PARR-E/Pi-Python-Project/src/readme.md

This directory contains the course code created for this project. Since I was the only CS major on the project, I did the vast majority of the coding.
