PARR-E/Pi-Python-Project/design/MatthewK_Solidworks_Files/readme.md

The Solidowkrs model files used by Matthew Killy to create the 3D-printed components for the project.
