PARR-E/Pi-Python-Project/other/Arducam Pi Camera invoice (redacted).png

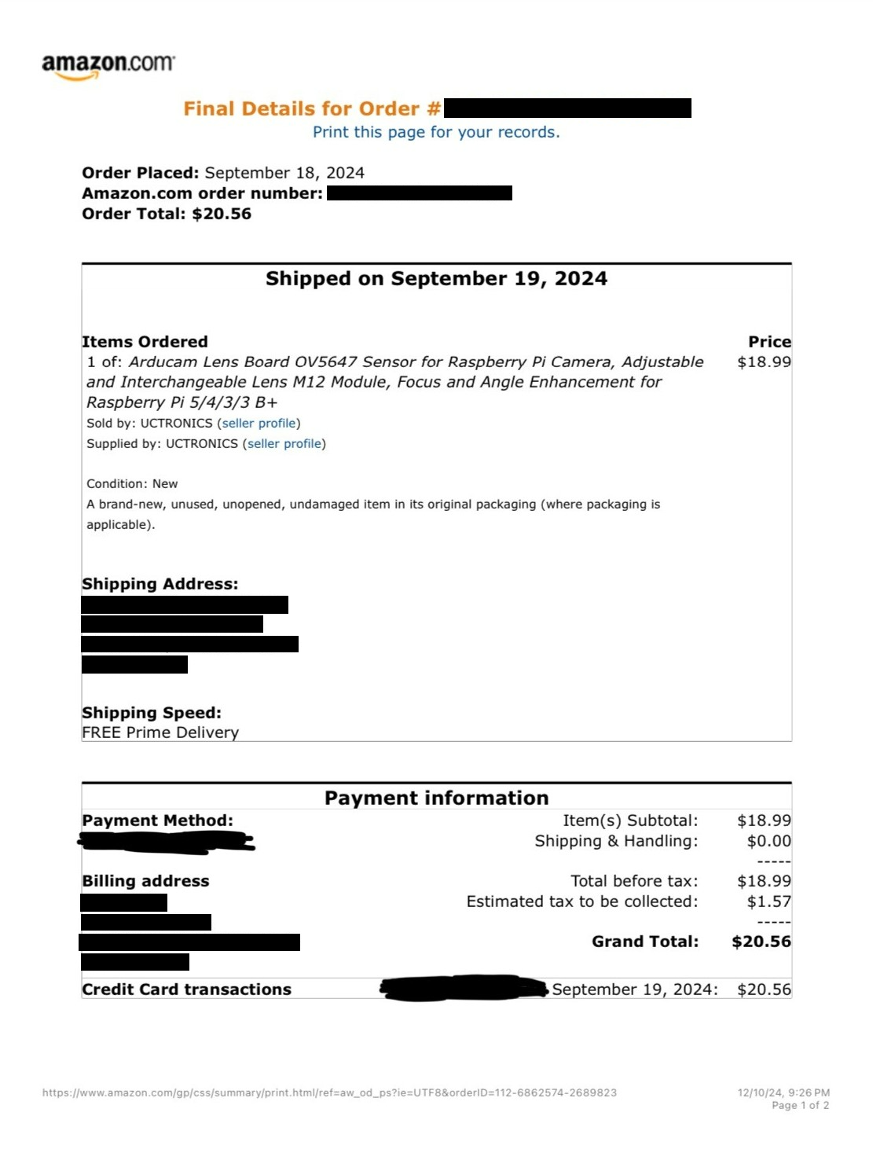
other/Arducam Pi Camera invoice (redacted).png
