PARR-E/Pi-Python-Project/other/CSI Flexible Cable invoice (redacted).png

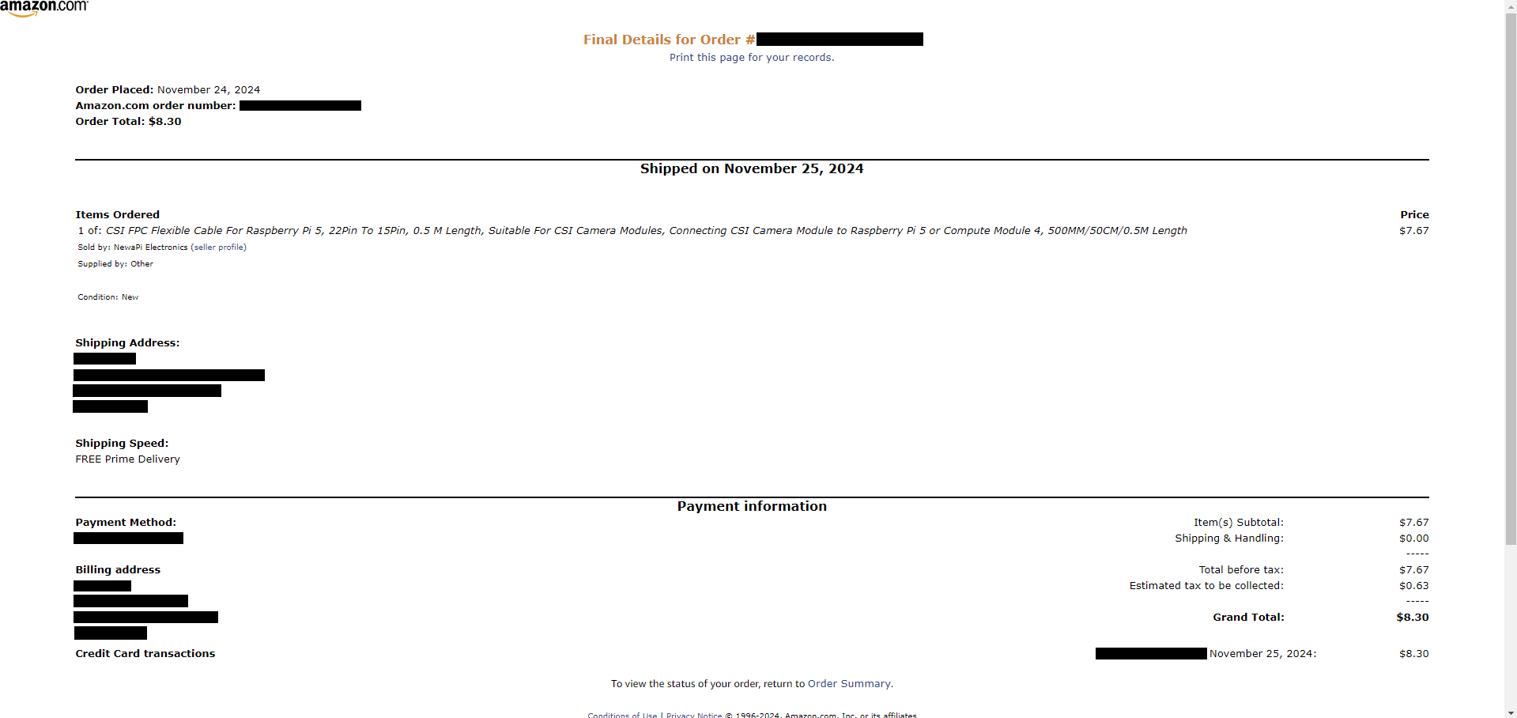
other/CSI Flexible Cable invoice (redacted).png
