PARR-E/Pi-Python-Project/design/MatthewK_Solidworks_Files/servo Assem.SLDASM

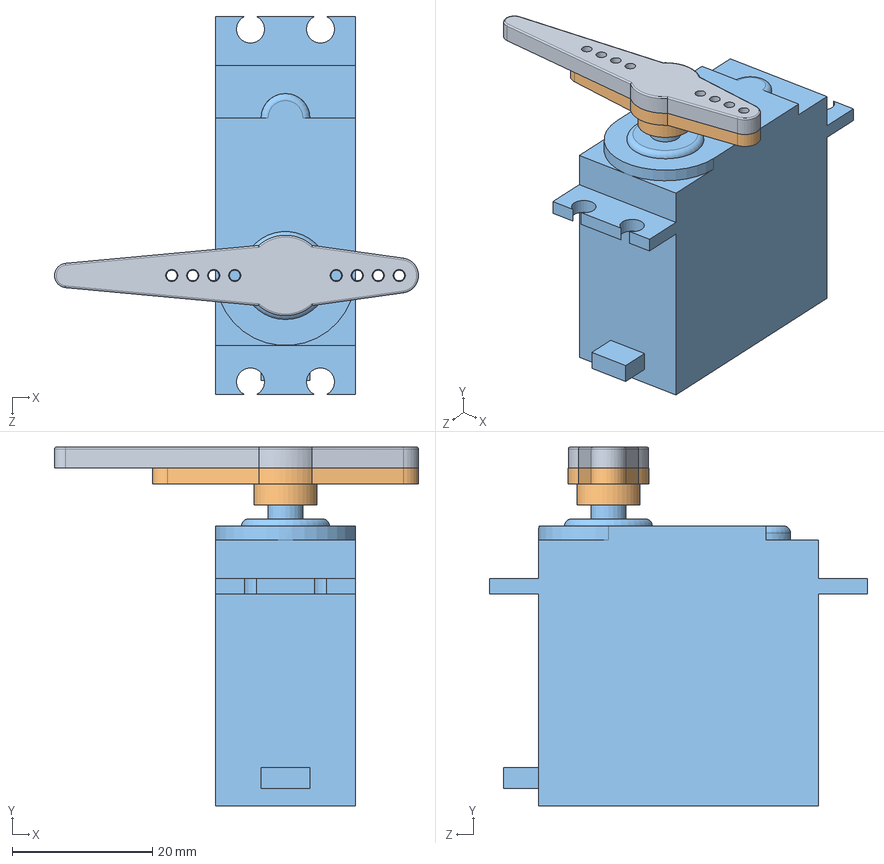
[picture p4: CAD file, 2025-05-14]
design/MatthewK_Solidworks_Files/servo Assem.SLDASM
52.0 x 51.2 x 54.0 mm
servo strong junk 2
Servo Horn
Servo Horn Extender
