PARR-E/Pi-Python-Project/design/MatthewK_Solidworks_Files/servo Assem 2.SLDASM

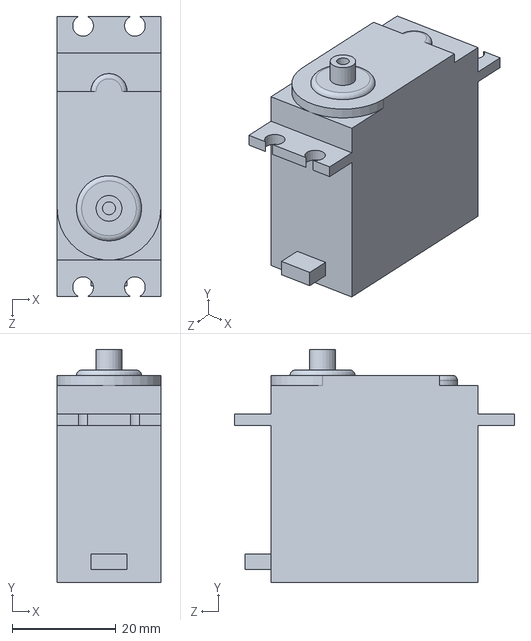
[picture p5: CAD file, 2025-05-14]
design/MatthewK_Solidworks_Files/servo Assem 2.SLDASM
20.0 x 45.0 x 54.0 mm
