PARR-E/Pi-Python-Project/design/MatthewK_Solidworks_Files/Main Bracket Part 1.SLDPRT

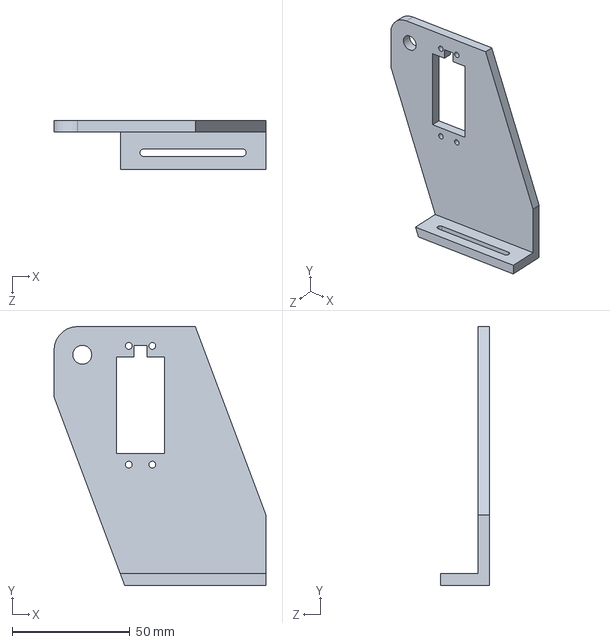
[picture p6: CAD file, 2025-05-14]
design/MatthewK_Solidworks_Files/Main Bracket Part 1.SLDPRT
90.0 x 110.0 x 21.0 mm
