PARR-E/Pi-Python-Project/design/MatthewK_Solidworks_Files/Main Bracket Part 2.SLDPRT

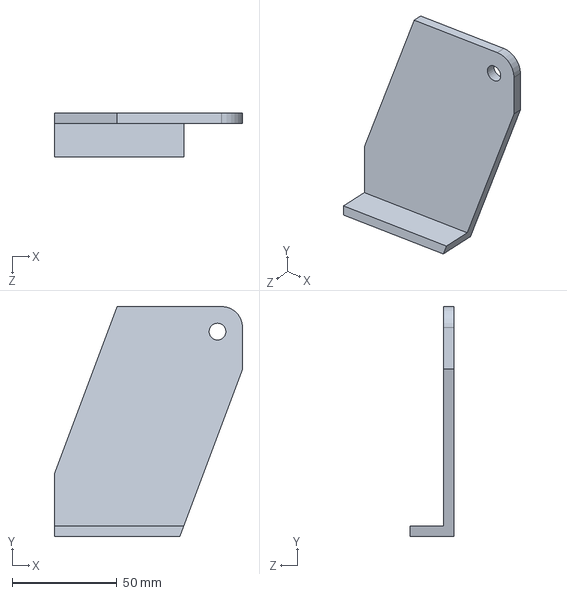
[picture p7: CAD file, 2025-05-14]
design/MatthewK_Solidworks_Files/Main Bracket Part 2.SLDPRT
90.0 x 110.0 x 21.0 mm
