PARR-E/Pi-Python-Project/design/MatthewK_Solidworks_Files/Servo Horn Extender 2.SLDPRT

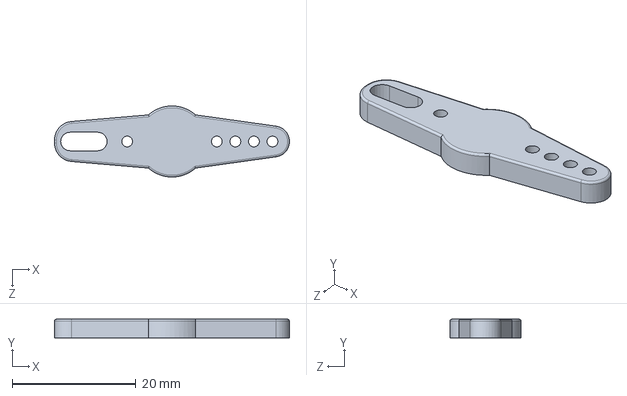
[picture p8: CAD file, 2025-05-14]
design/MatthewK_Solidworks_Files/Servo Horn Extender 2.SLDPRT
38.0 x 3.00 x 11.5 mm
