PARR-E/Pi-Python-Project/design/MatthewK_Solidworks_Files/Rotating Bracket Part 1.SLDPRT

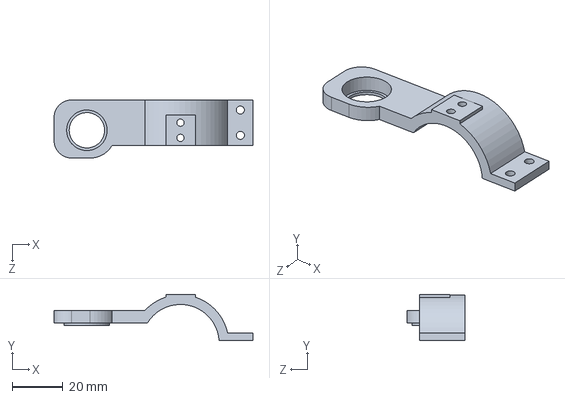
[picture p9: CAD file, 2025-05-14]
design/MatthewK_Solidworks_Files/Rotating Bracket Part 1.SLDPRT
78.7 x 18.3 x 23.0 mm
