PARR-E/Pi-Python-Project/design/MatthewK_Solidworks_Files/Camera Mount Stabilizer.SLDPRT

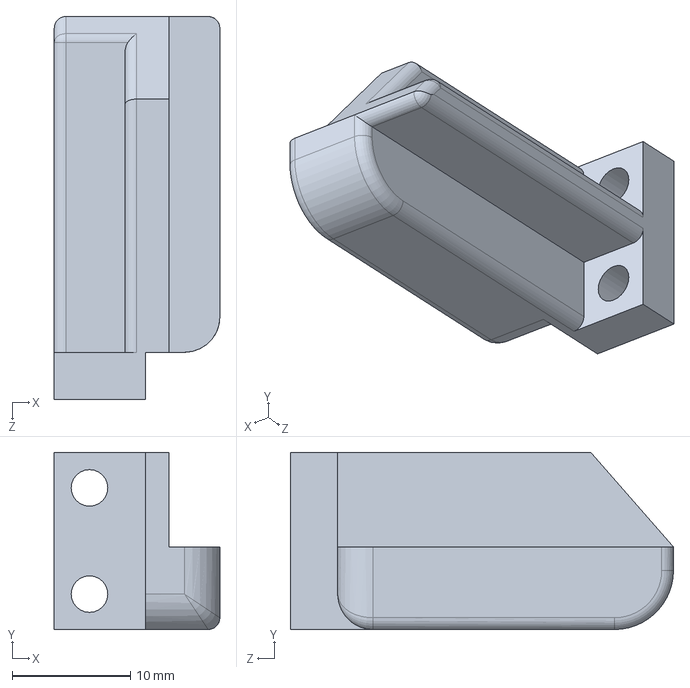
[picture p10: CAD file, 2025-05-14]
design/MatthewK_Solidworks_Files/Camera Mount Stabilizer.SLDPRT
14.1 x 15.0 x 32.5 mm
