PARR-E/Pi-Python-Project/design/MatthewK_Solidworks_Files/Servo Spinning Horn.SLDPRT

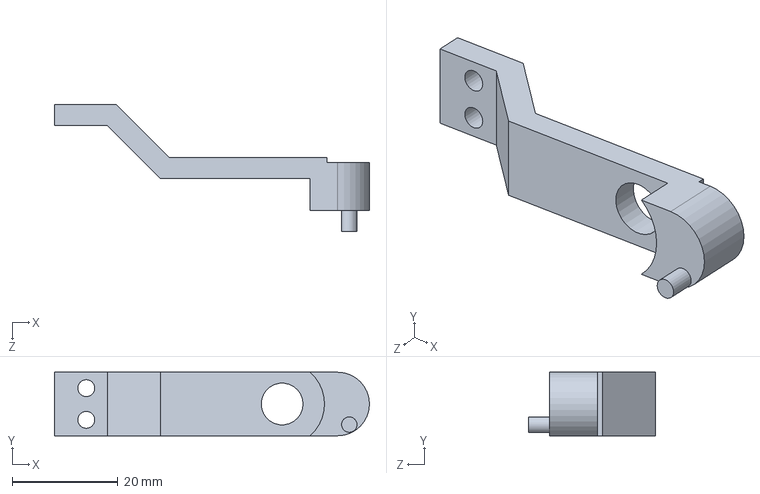
[picture p11: CAD file, 2025-05-14]
design/MatthewK_Solidworks_Files/Servo Spinning Horn.SLDPRT
59.5 x 12.0 x 24.0 mm
