PARR-E/Pi-Python-Project/design/MatthewK_Solidworks_Files/Bearing.SLDPRT

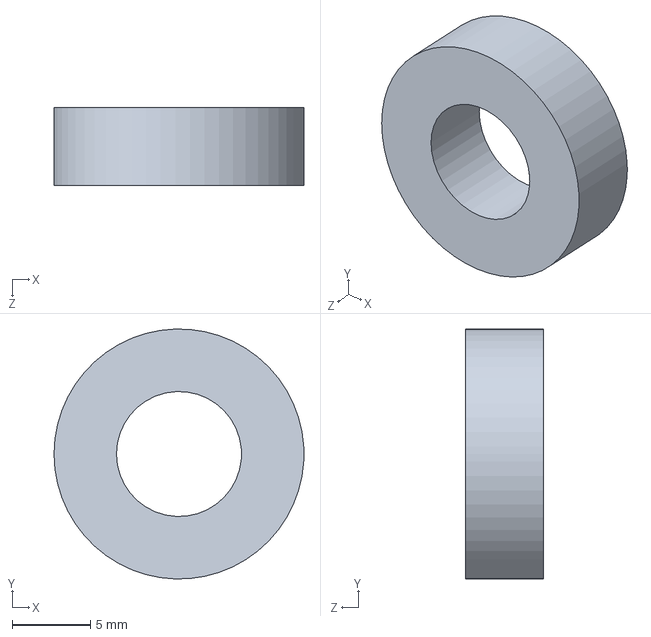
[picture p12: CAD file, 2025-05-14]
design/MatthewK_Solidworks_Files/Bearing.SLDPRT
16.0 x 16.0 x 5.00 mm
