PARR-E/Pi-Python-Project/design/MatthewK_Solidworks_Files/Outside Spacer.SLDPRT

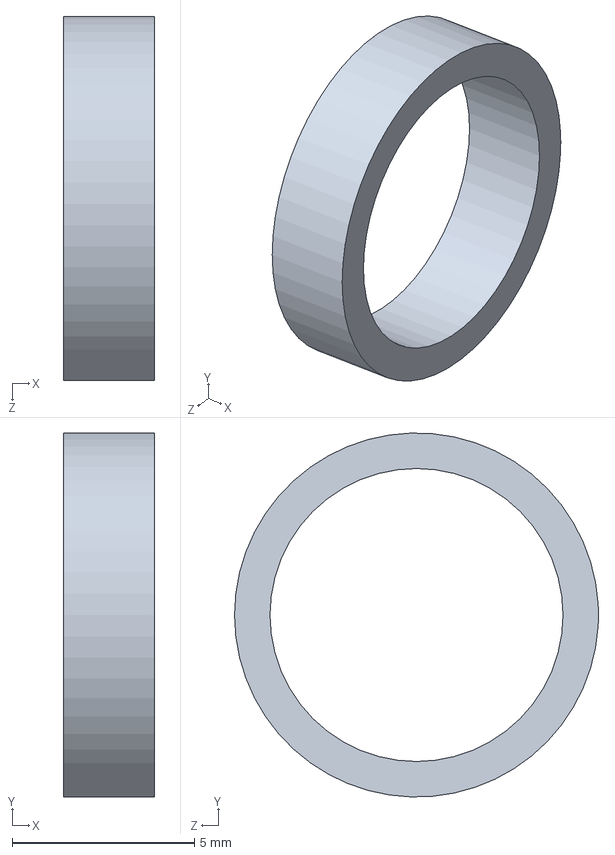
[picture p13: CAD file, 2025-05-14]
design/MatthewK_Solidworks_Files/Outside Spacer.SLDPRT
2.50 x 10.00 x 10.0 mm
