PARR-E/Pi-Python-Project/design/MatthewK_Solidworks_Files/Servo Horn Extender.SLDPRT

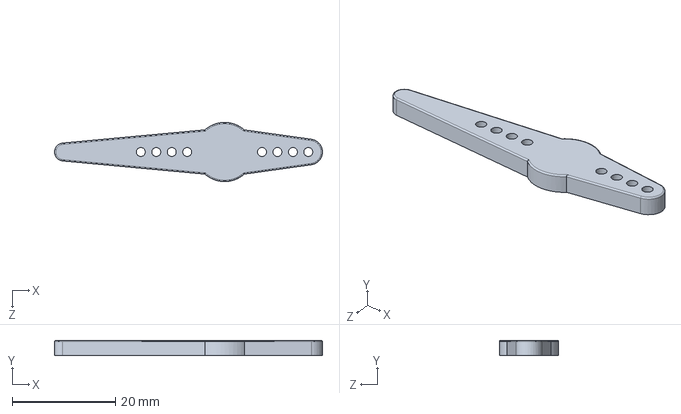
[picture p14: CAD file, 2025-05-14]
design/MatthewK_Solidworks_Files/Servo Horn Extender.SLDPRT
52.0 x 3.00 x 11.5 mm
