PARR-E/Pi-Python-Project/design/MatthewK_Solidworks_Files/Rotating Bracket Part 2.SLDPRT

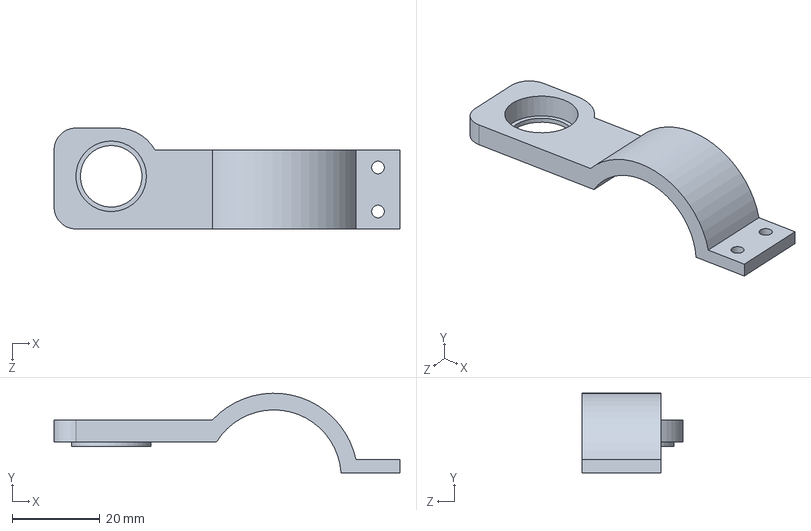
[picture p15: CAD file, 2025-05-14]
design/MatthewK_Solidworks_Files/Rotating Bracket Part 2.SLDPRT
78.7 x 18.1 x 23.0 mm
