PARR-E/Pi-Python-Project/design/MatthewK_Solidworks_Files/Camera Mount.SLDPRT

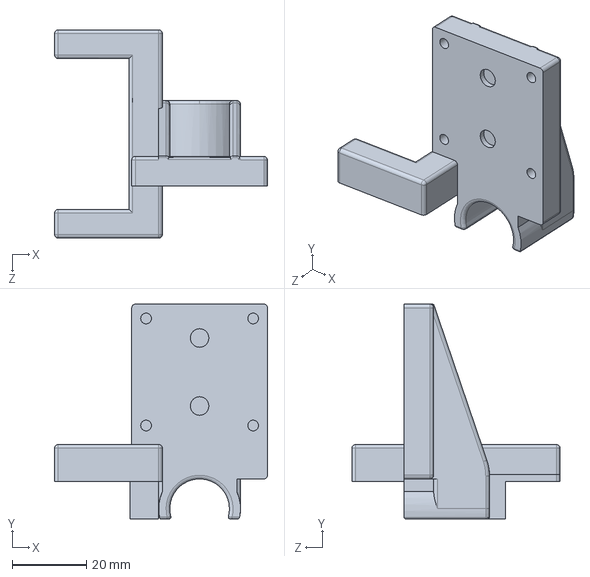
[picture p16: CAD file, 2025-05-14]
design/MatthewK_Solidworks_Files/Camera Mount.SLDPRT
57.2 x 57.7 x 56.0 mm
