PARR-E/Pi-Python-Project/design/MatthewK_Solidworks_Files/Servo Horn.SLDPRT

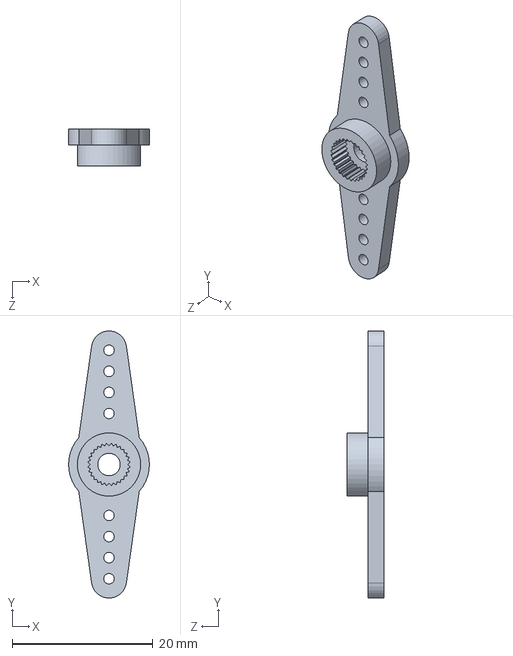
[picture p17: CAD file, 2025-05-14]
design/MatthewK_Solidworks_Files/Servo Horn.SLDPRT
11.5 x 38.0 x 5.25 mm
