PARR-E/Pi-Python-Project/design/MatthewK_Solidworks_Files/Middle Spacer.SLDPRT

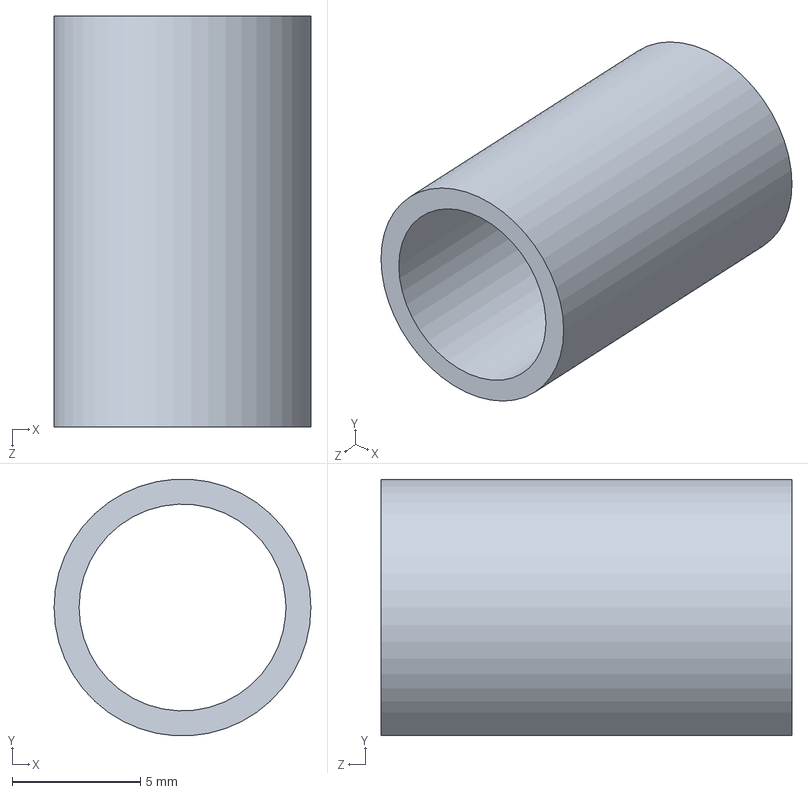
[picture p18: CAD file, 2025-05-14]
design/MatthewK_Solidworks_Files/Middle Spacer.SLDPRT
10.0 x 9.98 x 16.0 mm
