PARR-E/Pi-Python-Project/design/MatthewK_Solidworks_Files/Nut.SLDPRT

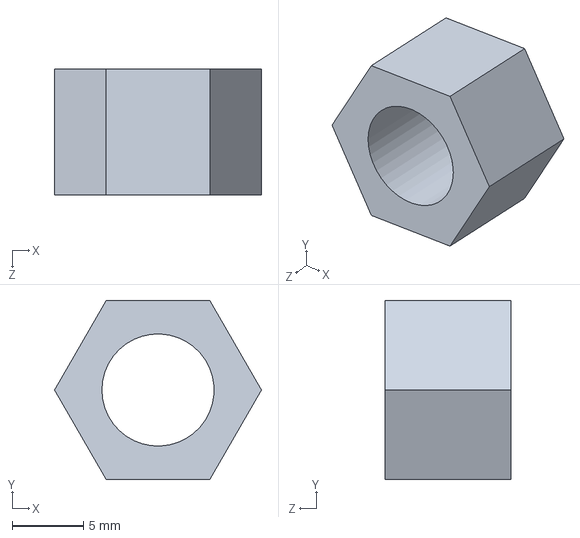
[picture p19: CAD file, 2025-05-14]
design/MatthewK_Solidworks_Files/Nut.SLDPRT
14.5 x 12.6 x 8.80 mm
