PARR-E/Pi-Python-Project/design/MatthewK_Solidworks_Files/Bolt.SLDPRT

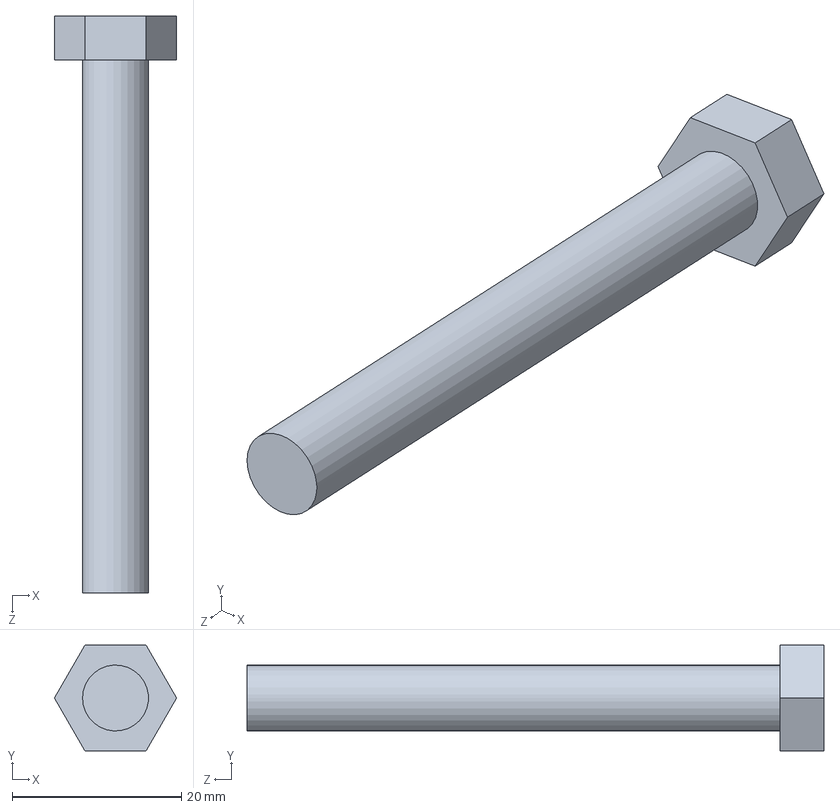
[picture p20: CAD file, 2025-05-14]
design/MatthewK_Solidworks_Files/Bolt.SLDPRT
14.5 x 12.5 x 68.2 mm
