PARR-E/Pi-Python-Project/(list of files, cad)

Other CAD files:
design/MatthewK_Solidworks_Files/servo strong junk 2.SLDPRT
