PARR-E/Pi-Python-Project/design/SamK_Circuit Diagram.pdf

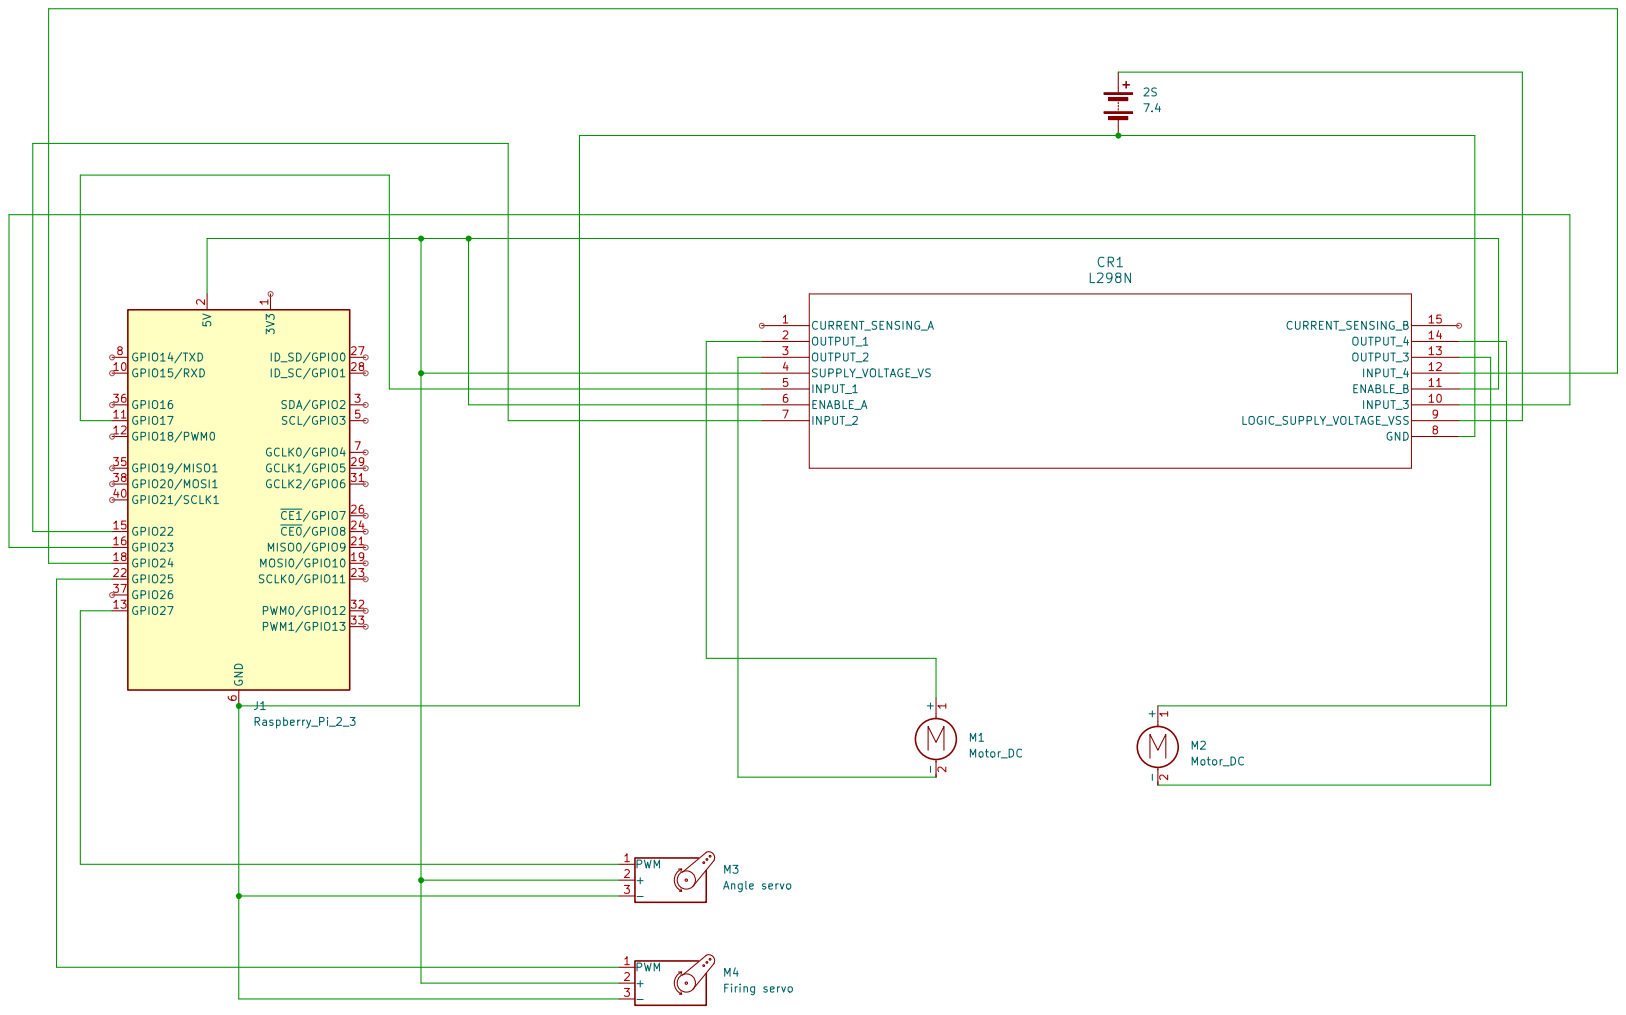
[picture p21: page 1]
