PARR-E/Pi-Python-Project/(commit log)

2025-05-14 Added Sam's circuit diagram.
2025-05-14 Added Matthew's Solidworks files.
    [Bearing.SLDPRT, Bolt.SLDPRT, Camera Mount Stabilizer.SLDPRT, Camera Mount.SLDPRT, Main Bracket Part 1.SLDPRT, Main Bracket Part 2.SLDPRT, Middle Spacer.SLDPRT, Nut.SLDPRT]
